cifertech/nRFBox/Schematic/nRFBOX-Schematic.jpg

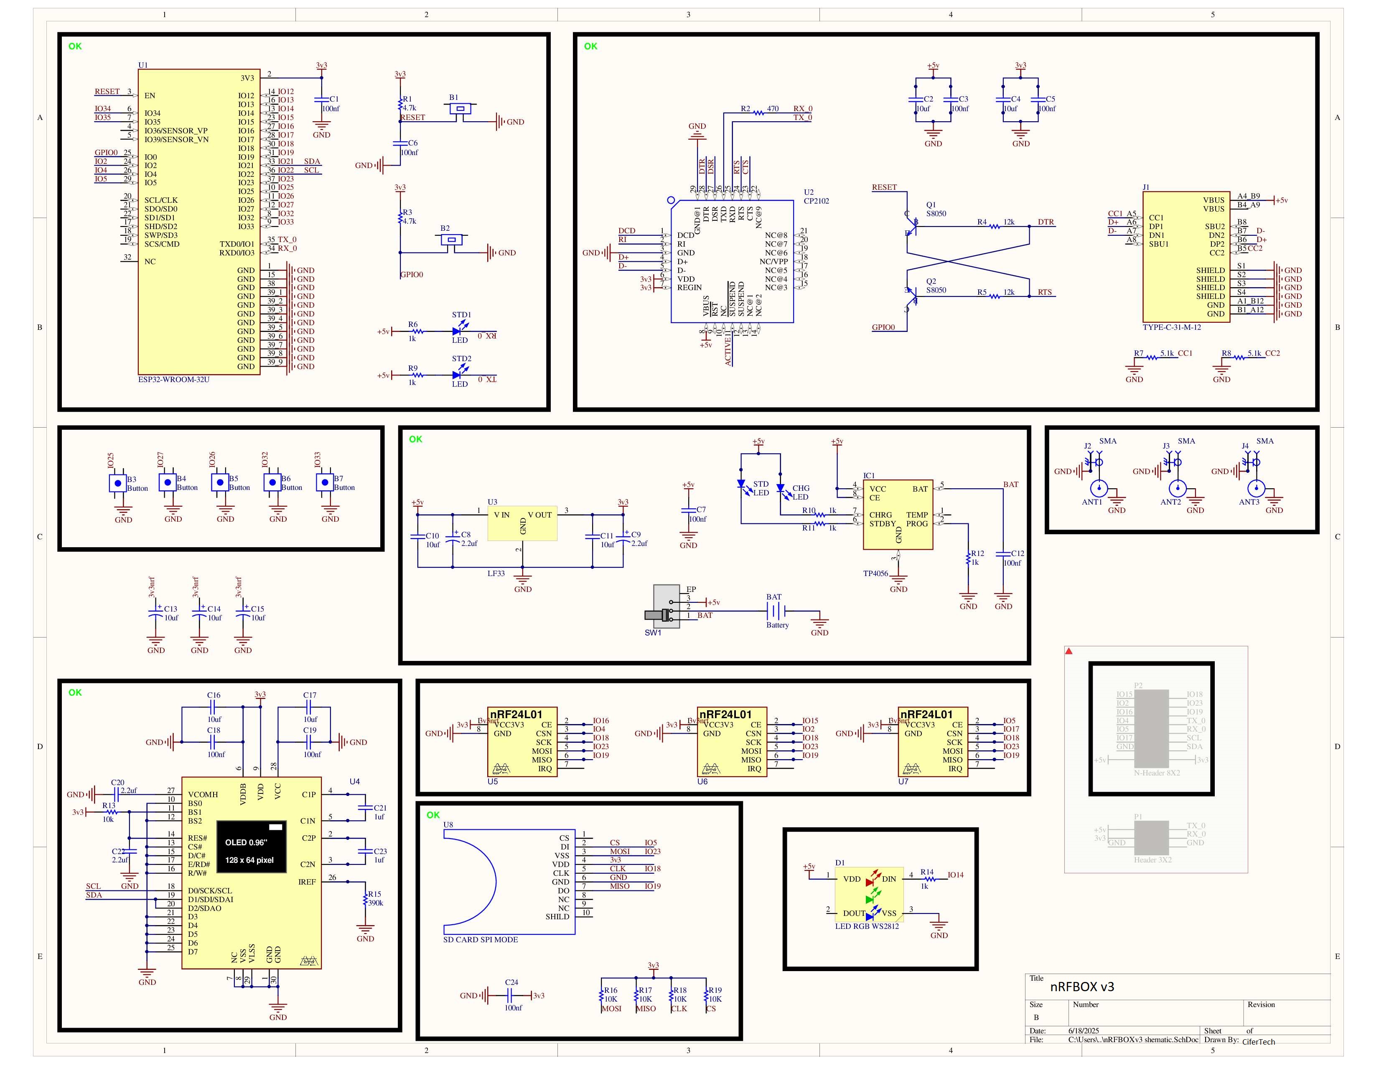
Schematic/nRFBOX-Schematic.jpg
