cifertech/nRFBox/PCB/PCB Print.jpg

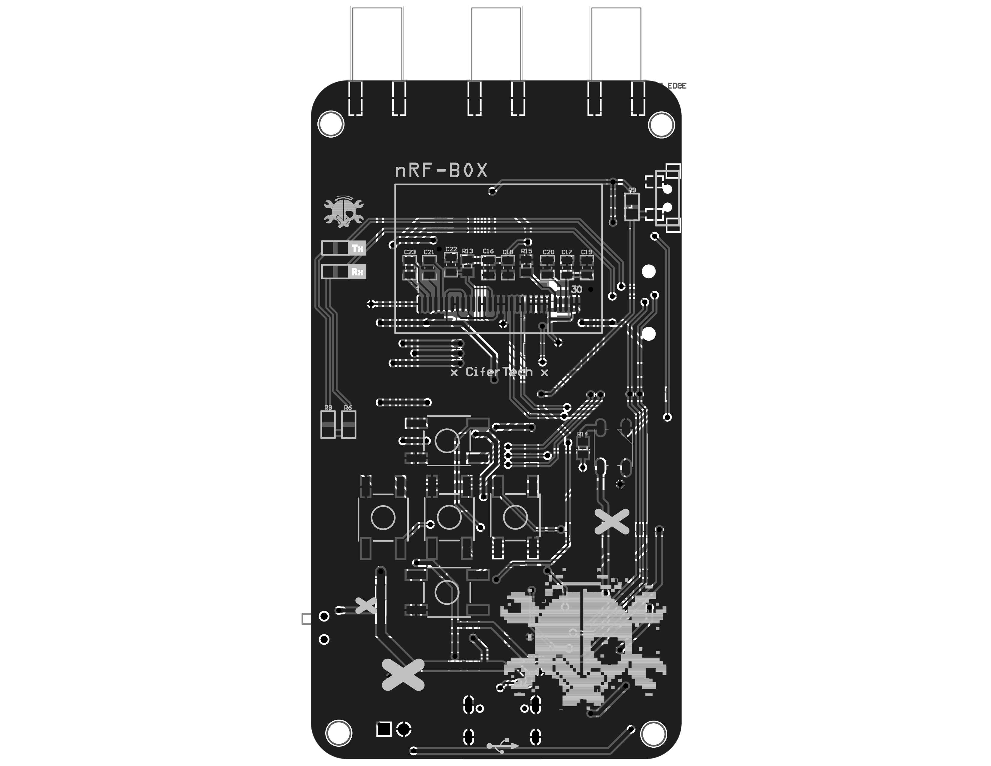
PCB/PCB Print.jpg
