cifertech/nRFBox/(threads)

Thread 5 (2023-02-10):

Rotary Encoder vs Buttons

AnonymeusOfficial, 2023-02-10:
Is there a way I can make this possible to use with a single rotary encoder, one direction is up and another is down the button would be to click enter and I'd use just one button for the back action.

jfjyfdyj6, 2025-07-19:
I used this one,its fit perfectly !

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

Thread 6 (2023-02-27):

pcb

Clayrecovery20, 2023-02-27:
can i get pcb design?

jlescalonap, 2024-08-23:
@cifertech could you sell the PCB design?

cifertech, 2024-09-04:
I have uploaded the PCB files for nRF-BOX V2.

https://github.com/cifertech/nRFBox/tree/main/PCB

zRCrackiiN, 2024-09-20:
I've assembled 2 now, both seem to have power issues, LF33 gets hot real fast I'm not even sure where to start diagnosing it haha

cifertech, 2024-09-20:
Hi @zRCrackiiN
Please provide photos of your assembled PCB and test your nRF-BOX without the C8 and C9 capacitors.

jlescalonap, 2024-09-20:
Sorry if this is not the right place to answer but, where did you order the PCBs? @zRCrackiiN

zRCrackiiN, 2024-09-20:
> Sorry if this is not the right place to answer but, where did you order the PCBs? @zRCrackiiN

pcbway

cifertech, 2024-09-20:
> im not sure i understand the power switch, when switched down (linking bat to BT1) it links the battery to the 4056, but when its up it links BT1 to +5v?

It's a clumsy logic design for controlling battery charging and powering on/off when the battery is connected, but it works.

If you are still experiencing issues with LF33, try to locate a short circuit. It's better to do the first tests with just one nRF24.

By the way, it's nice to see the nRF-BOX in purple!

zRCrackiiN, 2024-09-20:
I have a second board without the esp and the nrf modules, it's doing the same thing, definitely down the bottom of the board somewhere

cifertech, 2024-09-20:
> I have a second board without the esp and the nrf modules, it's doing the same thing, definitely down the bottom of the board somewhere

**Just following up on the LF33.**

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

zRCrackiiN, 2024-09-21:
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

im currently looking at this, i found that it was going to ground when not powered on the 5v side, when powered it stops going to ground, and powers up, but there is no output.

im also noticing that mine say ST GN LF33, not like yours, i cant find a spec sheet for the GN variant so i might need to try source other LF33 chips

zRCrackiiN, 2024-09-21:
basically, ive removed the GN LF33, added bench power to the 3v3 circuit and plugged in the usb, i was able to program and test, working well! i wonder if it really is just that reg!

jlescalonap, 2024-09-24:
> basically, ive removed the GN LF33, added bench power to the 3v3 circuit and plugged in the usb, i was able to program and test, working well! i wonder if it really is just that reg!

Could you please share how it enden up? @zRCrackiiN

zRCrackiiN, 2024-09-24:
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

I'll share after I've got the new lf33 added to the board, hopefully that fixes my issues

zRCrackiiN, 2024-11-20:
> Hey there @zRCrackiiN did you manage to solve the problem?

Yes, it appears to be bad LF33 components, my first order was from aliexpress, none of them worked.

Second order was from digikey and they work great

illlumin, 2024-12-06:
@zRCrackiiN,  could you share the 3D printing file? I’ve already ordered the circuit board and am currently looking for an enclosure for it. thank you

zRCrackiiN, 2024-12-30:
> @zRCrackiiN, could you share the 3D printing file? I’ve already ordered the circuit board and am currently looking for an enclosure for it. thank you

hey mate,
currently still in development but getting closer
![Uploading rn_image_picker_lib_temp_ab61d803-11be-495c-a5f5-df8ef0b73bba.jpg…]()

zRCrackiiN, 2024-12-30:
> @zRCrackiiN, could you share the 3D printing file? I’ve already ordered the circuit board and am currently looking for an enclosure for it. thank you

hey mate,
currently still in development but getting closer
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

Jeremiah-oAT, 2025-01-18:
I'm looking to have PCBWay completely assemble a few of these units. Does anyone have the pick and place files?

Thread 8 (2023-08-02):

Adafruit_SSD1306.h

MassFrequencies, 2023-08-02:
Hi,

can you please help me with this issue.

\Documents\Arduino\libraries\Adafruit_SSD1306\Adafruit_SSD1306.cpp:42:10: fatal error: pgmspace.h: No such file or directory
 #include <pgmspace.h>
          ^~~~~~~~~~~~
compilation terminated.

Thread 9 (2024-04-19):

No jamming code freezes

Ct114, 2024-04-19:
Compiled and uploaded as specified when in the jamming menu shows disabled and pressing button 2 causes the code to freeze

Thread 11 (2024-09-02):

PCB Gerber File

jayrogogn, 2024-09-02:
Hi, I didn't find the Gerber file in the main menu.
It is not in the "PCB" folder.
Could you make it available?

cifertech, 2024-09-04:
Hi @jayrogogn
I added the Gerber file, but you can also use .pcbdoc to order the PCB. Please ensure there are no issues before placing the order.

https://github.com/cifertech/nRFBox/tree/main/PCB

knlklabacka, 2024-09-09:
Good morning!  I uploaded the PCB file to JLCPCB and there are issues with the PCB that I'm not sure how to address.  Can you help?  The messages are from JLCPCB.

First issue:
As shown for 2 layer board ,the minimum via size is 0.3mm and the minimum via diameter is 0.5mm, can we increase the hole size and diameter to meet our capabilities?

Second issue:
slots in outline layer will cut the traces, should we delete them to proceed?
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

atsigr, 2024-10-12:
@cifertech i guess the pcb is with altium? Just a question, can you share the altium project so maybe we can adjust the pcb maybe for some of the materials ?

Thread 13 (2024-09-14):

spi communication problem

CtlAltDel6, 2024-09-14:
Breadboard build only works with a single radio attatched to the spi channel. Built with nodemcu wroom32 and using nrf24l01 + modules and breakout boards. I have only a single channel scope so I am unable to watch both ce and csn lines to confirm signal timing and transmition from multiple radios concurrently. Have confirmed spi coms as the issue by running diodes to spi on second and third radios. With that setup I get three radios active in multi jaming and a reliable signal in scanner and analyzer from radio 1, but of course no mesurable signal from radio 2 or 3.
I have tried 2 different proto board variations hoping that my jumper wires were at fault but both have failed.

opskrip, 2024-09-16:
Hello. I have the same story, but I don't understand it. Can you post a photo of how you did it?

CtlAltDel6, 2024-09-16:
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
I connected radio 1 straight to the spi bus pins and used three high speed switching diodes to connect both radio 2 and 3 together to the spi pins. This allows for the prepare radio logic to run and returns active on multi ble jammer.
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

CtlAltDel6, 2024-09-16:
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
Both prototype builds have the same issue

CtlAltDel6, 2024-09-16:
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
Both prototype builds fail in the same way

opskrip, 2024-09-17:
Thank you very much. I'm new to arduino, so I'm learning how to code through third-party projects. Have a nice day

cifertech, 2024-09-20:
Hi @CtlAltDel6
as I tested the project with 3 nRF24, your problem might be a power issue, but the SPI communication is always on the table, I will try to test to see if I can find the problem. If both prototypes fail in the same way, there might be something wrong with my code, but I will try to test it again.

By the way, that's a really impressive prototype.

CtlAltDel6, 2024-12-29:
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
Fixed in last update, rushed a messy case. 8.2" long, 3.6" wide, 1.2" depth including antenna. Thank you for all your hard work Cifertech

CtlAltDel6, 2024-12-29:
Closed, fully functional coms after update

Closed 2024-12-29.

Thread 15 (2024-09-17):

jammer transmission failed

marriusco, 2024-09-17:
Hi,
On Jamer. I get
Transmission failed, though scanning and analyzing works,

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

 so the NRF seems alive.

I double-checked the MISO MOSI SCK IRQ CS, I even changed the NRF.

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

Any idea ?

cifertech, 2024-09-20:
Hi @marriusco
The "Transmission failed" message is a bug that I will fix in the release. It's best to test the jammer with your IoT devices. Keep in mind that the jammer in nRF-BOX is not extremely powerful, but with the suitable options chosen in the jammer menu, it will work.

Thread 16 (2024-09-28):

OLED screen not working

logm1lo, 2024-09-28:
When I complied and flashed the code to esp32 WROOM U and connected the OLED screen to the esp32. The screen won't boot

logm1lo, 2024-09-28:
this is the output of the serial monitor

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

logm1lo, 2024-09-28:
the fix here is to wait for a couple of hours and turn it back again. Works like a charm

Dev-Khrish, 2024-12-18:
how did you get it to work ?

logm1lo, 2024-12-20:
> how did you get it to work ?

I still doesn't understand why I got it to work

Dev-Khrish, 2024-12-20:
Can you share a bit of schematics/screenshots of wiring or the code you used please

logm1lo, 2024-12-23:
> Can you share a bit of schematics/screenshots of wiring or the code you used please

Here it is, it's a bit messy tho:
https://github.com/cifertech/nRFBox/issues/17

Closed 2024-09-28.

Thread 17 (2024-09-28):

Button wiring doesn't work

logm1lo, 2024-09-28:
I've tried to wire the buttons to the breadboard and ESP32 as guided, but the buttons seems like it doesn't respond or received my inputs

Here are a couple of photos of the wiring:

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

logm1lo, 2024-09-28:
Also, love the project that you're building. It's fantastic!

Thread 18 (2024-09-29):

USB connector

marriusco, 2024-09-29:
The PCB for the usb female, what is the USB type.

atsigr, 2024-10-12:
@marriusco  Yes it is 3.1 and i believe this mach the footprint.
https://www.snapeda.com/parts/TYPE-C-31-M-12/HRO%20Electronics%20Co.,%20Ltd./view-part/

Thread 19 (2024-09-29):

Missing info on BOM

SoLongSidekick, 2024-09-29:
The tantalum cap at C8/C9 doesn't have a value listed in the BOM, anyone figure it out? Also is it safe to assume the rest of the caps are standard ceramic caps?

atsigr, 2024-10-12:
@SoLongSidekick If you see schematic C8/C9 is 2.2 uf (1206 footprint) . As for the other capacitors are 805 and some are 1206 (C10,C11) footprint (yes ceramic).

Thread 20 (2024-10-12):

Difference between 1KOhm 0805 resistor and 1KOhm 0805 (2012X06L) resistor?

VNEvil, 2024-10-12:
Hello @cifertech  and everyone!

In the 'nRFBOXv2 BOM.pdf' list, there are two types of resistors: 1KOhm 0805 and 1KOhm 0805 (2012X06L). Is there any difference between them? Can I use the 1KOhm 0805 (2012M) resistor to replace the 1KOhm 0805 (2012X06L) resistor?
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

I am looking forward to receiving a response
Thank you very much!

atsigr, 2024-10-13:
@VNEvil i think the 2012X06L. is on the metric System were is corect 2012M and 06 is the pad size as standrad all the 0805 RES are. Pretty sure you can use 1KOhm 0805 (2012M)

VNEvil, 2024-10-13:
Thank you!

UrbanTrip96, 2025-02-13:
> @VNEvil i think the 2012X06L. is on the metric System were is corect 2012M and 06 is the pad size as standrad all the 0805 RES are. Pretty sure you can use 1KOhm 0805 (2012M)

Are they interchangeable?

Thread 21 (2024-10-14):

.bin not working

sameepgod, 2024-10-14:
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

i have been trying to make this project decided to test it out on breadboard  but im not the output

mahmoudgamalmmg8, 2024-10-19:
i have same problem did u find a solution?

abasith-ak, 2024-11-04:
same bro

amir8el2, 2024-11-27:
I have this problem too. Has anyone been able to fix this problem?

ahmadjutt611, 2024-12-13:
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
 I have also same issue the bin is not showing any display but if upload code with ARDUINO IDE then there are many errors in code and after error resolve the display is working also analyzer working but jammer not working

Thread 23 (2024-10-25):

it's not working at all

abasith-ak, 2024-10-25:
I uploaded the bin to esp32, but it's not working at all. The screen doesn't turn on.

abasith-ak, 2024-10-25:
@cifertech  pls help

Thread 24 (2024-10-27):

The radio.write() always returns 0.

gugo2808, 2024-10-27:
Hello, today built the 3 nrf Version in breadboard with esp32s3.

All seems to be fine, but, radio.write() returns always 0, so I don't understand whether it working, or just auto-ack doesn't work.

I don't understand how to jam something actually, all my devices, like my watch or headphones remained connected.

I'm using nrf24l01+

Thank you! And good luck with development!😃

Thread 25 (2024-11-07):

nrf-box v1

ElamrawyTamer, 2024-11-07:
Hi, can you please send the schematics of the firse nrf-box? I just don't know how to connect buttons, charging controller and, etc? It's just I already built the second version and want to test the first one. Thank you

knlklabacka, 2024-11-08:
@ElamrawyTamer can you help me with version 2?  Can you share how you got it working?  Did you order a PCB?  I tried uploading the file to JLCPCB and they came back with the board had errors.

ElamrawyTamer, 2024-11-08:
@knlklabacka i used breadboard and i did soldering with the jumper wires, because I didn't want to risk buying wrong PCBs. I also found a video on tiktok, that helped me a lot: https://www.tiktok.com/@testando_tecnologias/video/7425052647775849734

knlklabacka, 2024-11-08:
Thank you @ElamrawyTamer I will take a look.

ElamrawyTamer, 2024-11-09:
@cifertech ?

SoLongSidekick, 2024-11-30:
> @knlklabacka i used breadboard and i did soldering with the jumper wires, because I didn't want to risk buying wrong PCBs. I also found a video on tiktok, that helped me a lot: https://www.tiktok.com/@testando_tecnologias/video/7425052647775849734

No way, no freaking way. Get the fuck out of here, nice find my dude. Crap, this means I finally have to just sack up and add Tiktok to my media appetite. Seriously, thanks for posting.

I'm... ... eh... 60-80% positive I downloaded the PCB Gerbers before v2 ever came out. I bookmarked this page well before v2 so it's very plausible. I'll dig around a bit and see if that is indeed the case, and if so I'll report back here.

AntonioDVZ, 2025-04-27:
> Hi, can you please send the schematics of the firse nrf-box? I just don't know how to connect buttons, charging controller and, etc? It's just I already built the second version and want to test the first one. Thank you

Hi. If you received the schematic version 1, can you send it to me?

Thread 26 (2024-11-13):

missing cpl file?

Spacedreamer0, 2024-11-13:
hello i wanted to follow the project but i don't have the required experience or tools to assemble it and wanted to have it assembled on jlcpcb but it asks me for a cpl file which i cant find. Do i miss something?

zarni99, 2024-11-28:
I also looking for cpl file and does anyone has share it here, please

nechry, 2024-12-18:
I'm also looking for the BOM and CPL for jlcpcb format.

gel3k, 2024-12-27:
also interested

knlklabacka, 2024-12-27:
Also interested

nechry, 2025-01-02:
I tried to order only PCB via jlcpcb, but the provided Gerber didn't pass the audit. is the reason:
There are minimum hole size of 0.25 mm, with a diameter of 0.35mm in your file, to ensure the quality for your order, the 4-Wire Kelvin Test and via filling are necessary, so you may need to pay for an extra cost for it.

Thread 28 (2024-12-06):

Graber file error: via hole issue

illlumin, 2024-12-06:
Thank you for this amazing project! I have downloaded the Gerber file for production, but the manufacturer informed me about an issue with the file. How can I fix this problem? I would greatly appreciate your support. Thank you!
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

"The file shows that the via hole has an inner diameter of 0.25mm and an outer diameter of 0.35mm, which exceeds our standard production process. (For single-sided and double-sided boards, the minimum hole diameter is typically 0.3mm, and the outer diameter is 0.4mm.)"

UrbanTrip96, 2025-02-17:
I have the same problem. What should I do?

Thread 32 (2024-12-24):

when a press enter in different options freezes and need to restart

SSnoody, 2024-12-24:
idk if is the new verision or my firmware is broke, i try with 2 diff esp32 and still the same thing, i actually flash both with arduino ide, the .bin way it doesnt flash the esp32

akftec, 2025-01-12:
i have same problem. did u found a solution?

akftec, 2025-01-12:
hi i found my problem. i think u have same problem
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

SSnoody, 2025-01-12:
> hi i found my problem. i think u have same problem just follow this ![image](https://private-user-images.githubusercontent.com/194712128/402380723-d080e17c-ad8f-41c1-ad5e-42cc400ca090.png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)

I have that config too, but still frozen, for example if i press the jammer it works, if i go back and press the jammer again it froze it, i cant press the same function again because it froze

akftec, 2025-01-13:
https://randomnerdtutorials.com/esp32-erase-flash-memory/ hi can u try this  if u cant acces python in terminal  try the install in microsoft store.  and i used the esp32 library version is 1.0.5 try this version after all this upload esp32  on arduino ide

Thread 34 (2024-12-29):

error: cannot convert 'std::string'

ahmadjutt611, 2024-12-29:
I have these error in spoofer.cpp in the switches

switch (deviceType) {
  case 1:
    oAdvertisementData.setManufacturerData(String((char *)dataAirpods).substring(0, 31));
    break;
  case 2:
    oAdvertisementData.setManufacturerData(String((char *)dataAirpodsPro).substring(0, 31));
    break;
  case 3:
    oAdvertisementData.setManufacturerData(String((char *)dataAirpodsMax).substring(0, 31));
    break;
  case 4:
    oAdvertisementData.setManufacturerData(String((char *)dataAirpodsGen2).substring(0, 31));
    break;

wajiho23, 2024-12-29:
I have the same error: `C:\Users\wajih\Downloads\nRFBox-2.2.1\nRFBox-2.2.1\nRFBox_V2\sourapple.cpp: In function 'BLEAdvertisementData getOAdvertisementData()':
C:\Users\wajih\Downloads\nRFBox-2.2.1\nRFBox-2.2.1\nRFBox_V2\sourapple.cpp:78:34: error: cannot convert 'std::string' {aka 'std::__cxx11::basic_string<char>'} to 'String'
   78 |   advertisementData.addData(std::string((char *)packet, 17));
      |                                  ^~~~~~~~~~~~~~~~~~~~~~~~~~
      |                                  |
      |                                  std::string {aka std::__cxx11::basic_string<char>}
In file included from C:\Users\wajih\AppData\Local\Arduino15\packages\esp32\hardware\esp32\3.0.7\libraries\BLE\src/BLEServer.h:22,
                 from C:\Users\wajih\AppData\Local\Arduino15\packages\esp32\hardware\esp32\3.0.7\libraries\BLE\src/BLEDevice.h:21,
                 from C:\Users\wajih\Downloads\nRFBox-2.2.1\nRFBox-2.2.1\nRFBox_V2\sourapple.h:9,
                 from C:\Users\wajih\Downloads\nRFBox-2.2.1\nRFBox-2.2.1\nRFBox_V2\sourapple.cpp:7:
C:\Users\wajih\AppData\Local\Arduino15\packages\esp32\hardware\esp32\3.0.7\libraries\BLE\src/BLEAdvertising.h:36:23: note:   initializing argument 1 of 'void BLEAdvertisementData::addData(String)'
   36 |   void addData(String data);  // Add data to the payload.
      |                ~~~~~~~^~~~
C:\Users\wajih\Downloads\nRFBox-2.2.1\nRFBox-2.2.1\nRFBox_V2\spoofer.cpp: In function 'void setAdvertisingData()':
C:\Users\wajih\Downloads\nRFBox-2.2.1\nRFBox-2.2.1\nRFBox_V2\spoofer.cpp:197:49: error: cannot convert 'std::string' {aka 'std::__cxx11::basic_string<char>'} to 'String'
  197 |     oAdvertisementData.setManufacturerData(std::string((char *)dataAirpods, 31));
      |                                                 ^~~~~~~~~~~~~~~~~~~~~~~~~~~~~~~
      |                                                 |
      |                                                 std::string {aka std::__cxx11::basic_string<char>}
In file included from C:\Users\wajih\AppData\Local\Arduino15\packages\esp32\hardware\esp32\3.0.7\libraries\BLE\src/BLEServer.h:22,
                 from C:\Users\wajih\AppData\Local\Arduino15\packages\esp32\hardware\esp32\3.0.7\libraries\BLE\src/BLEDevice.h:21,
                 from C:\Users\wajih\Downloads\nRFBox-2.2.1\nRFBox-2.2.1\nRFBox_V2\spoofer.h:9,
                 from C:\Users\wajih\Downloads\nRFBox-2.2.1\nRFBox-2.2.1\nRFBox_V2\spoofer.cpp:7:
C:\Users\wajih\AppData\Local\Arduino15\packages\esp32\hardware\esp32\3.0.7\libraries\BLE\src/BLEAdvertising.h:31:35: note:   initializing argument 1 of 'void BLEAdvertisementData::setManufacturerData(String)'
   31 |   void setManufacturerData(String data);
      |                            ~~~~~~~^~~~
C:\Users\wajih\Downloads\nRFBox-2.2.1\nRFBox-2.2.1\nRFBox_V2\spoofer.cpp:200:49: error: cannot convert 'std::string' {aka 'std::__cxx11::basic_string<char>'} to 'String'
  200 |     oAdvertisementData.setManufacturerData(std::string((char *)dataAirpodsPro, 31));
      |                                                 ^~~~~~~~~~~~~~~~~~~~~~~~~~~~~~~~~~
      |                                                 |
      |                                                 std::string {aka std::__cxx11::basic_string<char>}
C:\Users\wajih\AppData\Local\Arduino15\packages\esp32\hardware\esp32\3.0.7\libraries\BLE\src/BLEAdvertising.h:31:35: note:   initializing argument 1 of 'void BLEAdvertisementData::setManufacturerData(String)'
   31 |   void setManufacturerData(String data);
      |                            ~~~~~~~^~~~
C:\Users\wajih\Downloads\nRFBox-2.2.1\nRFBox-2.2.1\nRFBox_V2\spoofer.cpp:203:49: error: cannot convert 'std::string' {aka 'std::__cxx11::basic_string<char>'} to 'String'
  203 |     oAdvertisementData.setManufacturerData(std::string((char *)dataAirpodsMax, 31));
      |                                                 ^~~~~~~~~~~~~~~~~~~~~~~~~~~~~~~~~~
      |                                                 |
      |                                                 std::string {aka std::__cxx11::basic_string<char>}
C:\Users\wajih\AppData\Local\Arduino15\packages\esp32\hardware\esp32\3.0.7\libraries\BLE\src/BLEAdvertising.h:31:35: note:   initializing argument 1 of 'void BLEAdvertisementData::setManufacturerData(String)'
   31 |   void setManufacturerData(String data);
      |                            ~~~~~~~^~~~
C:\Users\wajih\Downloads\nRFBox-2.2.1\nRFBox-2.2.1\nRFBox_V2\spoofer.cpp:206:49: error: cannot convert 'std::string' {aka 'std::__cxx11::basic_string<char>'} to 'String'
  206 |     oAdvertisementData.setManufacturerData(std::string((char *)dataAirpodsGen2, 31));
      |                                                 ^~~~~~~~~~~~~~~~~~~~~~~~~~~~~~~~~~~
      |                                                 |
      |                                                 std::string {aka std::__cxx11::basic_string<char>}
C:\Users\wajih\AppData\Local\Arduino15\packages\esp32\hardware\esp32\3.0.7\libraries\BLE\src/BLEAdvertising.h:31:35: note:   initializing argument 1 of 'void BLEAdvertisementData::setManufacturerData(String)'
   31 |   void setManufacturerData(String data);
      |                            ~~~~~~~^~~~
C:\Users\wajih\Downloads\nRFBox-2.2.1\nRFBox-2.2.1\nRFBox_V2\spoofer.cpp:209:49: error: cannot convert 'std::string' {aka 'std::__cxx11::basic_string<char>'} to 'String'
  209 |     oAdvertisementData.setManufacturerData(std::string((char *)dataAirpodsGen3, 31));
      |                                                 ^~~~~~~~~~~~~~~~~~~~~~~~~~~~~~~~~~~
      |                                                 |
      |                                                 std::string {aka std::__cxx11::basic_string<char>}
C:\Users\wajih\AppData\Local\Arduino15\packages\esp32\hardware\esp32\3.0.7\libraries\BLE\src/BLEAdvertising.h:31:35: note:   initializing argument 1 of 'void BLEAdvertisementData::setManufacturerData(String)'
   31 |   void setManufacturerData(String data);
      |                            ~~~~~~~^~~~
C:\Users\wajih\Downloads\nRFBox-2.2.1\nRFBox-2.2.1\nRFBox_V2\spoofer.cpp:212:49: error: cannot convert 'std::string' {aka 'std::__cxx11::basic_string<char>'} to 'String'
  212 |     oAdvertisementData.setManufacturerData(std::string((char *)dataAirpodsProGen2, 31));
      |                                                 ^~~~~~~~~~~~~~~~~~~~~~~~~~~~~~~~~~~~~~
      |                                                 |
      |                                                 std::string {aka std::__cxx11::basic_string<char>}
C:\Users\wajih\AppData\Local\Arduino15\packages\esp32\hardware\esp32\3.0.7\libraries\BLE\src/BLEAdvertising.h:31:35: note:   initializing argument 1 of 'void BLEAdvertisementData::setManufacturerData(String)'
   31 |   void setManufacturerData(String data);
      |                            ~~~~~~~^~~~
C:\Users\wajih\Downloads\nRFBox-2.2.1\nRFBox-2.2.1\nRFBox_V2\spoofer.cpp:215:49: error: cannot convert 'std::string' {aka 'std::__cxx11::basic_string<char>'} to 'String'
  215 |     oAdvertisementData.setManufacturerData(std::string((char *)dataPowerBeats, 31));
      |                                                 ^~~~~~~~~~~~~~~~~~~~~~~~~~~~~~~~~~
      |                                                 |
      |                                                 std::string {aka std::__cxx11::basic_string<char>}
C:\Users\wajih\AppData\Local\Arduino15\packages\esp32\hardware\esp32\3.0.7\libraries\BLE\src/BLEAdvertising.h:31:35: note:   initializing argument 1 of 'void BLEAdvertisementData::setManufacturerData(String)'
   31 |   void setManufacturerData(String data);
      |                            ~~~~~~~^~~~
C:\Users\wajih\Downloads\nRFBox-2.2.1\nRFBox-2.2.1\nRFBox_V2\spoofer.cpp:218:49: error: cannot convert 'std::string' {aka 'std::__cxx11::basic_string<char>'} to 'String'
  218 |     oAdvertisementData.setManufacturerData(std::string((char *)dataPowerBeatsPro, 31));
      |                                                 ^~~~~~~~~~~~~~~~~~~~~~~~~~~~~~~~~~~~~
      |                                                 |
      |                                                 std::string {aka std::__cxx11::basic_string<char>}
C:\Users\wajih\AppData\Local\Arduino15\packages\esp32\hardware\esp32\3.0.7\libraries\BLE\src/BLEAdvertising.h:31:35: note:   initializing argument 1 of 'void BLEAdvertisementData::setManufacturerData(String)'
   31 |   void setManufacturerData(String data);
      |                            ~~~~~~~^~~~
C:\Users\wajih\Downloads\nRFBox-2.2.1\nRFBox-2.2.1\nRFBox_V2\spoofer.cpp:221:49: error: cannot convert 'std::string' {aka 'std::__cxx11::basic_string<char>'} to 'String'
  221 |     oAdvertisementData.setManufacturerData(std::string((char *)dataBeatsSoloPro, 31));
      |                                                 ^~~~~~~~~~~~~~~~~~~~~~~~~~~~~~~~~~~~
      |                                                 |
      |                                                 std::string {aka std::__cxx11::basic_string<char>}
C:\Users\wajih\AppData\Local\Arduino15\packages\esp32\hardware\esp32\3.0.7\libraries\BLE\src/BLEAdvertising.h:31:35: note:   initializing argument 1 of 'void BLEAdvertisementData::setManufacturerData(String)'
   31 |   void setManufacturerData(String data);
      |                            ~~~~~~~^~~~
C:\Users\wajih\Downloads\nRFBox-2.2.1\nRFBox-2.2.1\nRFBox_V2\spoofer.cpp:224:49: error: cannot convert 'std::string' {aka 'std::__cxx11::basic_string<char>'} to 'String'
  224 |     oAdvertisementData.setManufacturerData(std::string((char *)dataBeatsStudioBuds, 31));
      |                                                 ^~~~~~~~~~~~~~~~~~~~~~~~~~~~~~~~~~~~~~~
      |                                                 |
      |                                                 std::string {aka std::__cxx11::basic_string<char>}
C:\Users\wajih\AppData\Local\Arduino15\packages\esp32\hardware\esp32\3.0.7\libraries\BLE\src/BLEAdvertising.h:31:35: note:   initializing argument 1 of 'void BLEAdvertisementData::setManufacturerData(String)'
   31 |   void setManufacturerData(String data);
      |                            ~~~~~~~^~~~
C:\Users\wajih\Downloads\nRFBox-2.2.1\nRFBox-2.2.1\nRFBox_V2\spoofer.cpp:227:49: error: cannot convert 'std::string' {aka 'std::__cxx11::basic_string<char>'} to 'String'
  227 |     oAdvertisementData.setManufacturerData(std::string((char *)dataBeatsFlex, 31));
      |                                                 ^~~~~~~~~~~~~~~~~~~~~~~~~~~~~~~~~
      |                                                 |
      |                                                 std::string {aka std::__cxx11::basic_string<char>}
C:\Users\wajih\AppData\Local\Arduino15\packages\esp32\hardware\esp32\3.0.7\libraries\BLE\src/BLEAdvertising.h:31:35: note:   initializing argument 1 of 'void BLEAdvertisementData::setManufacturerData(String)'
   31 |   void setManufacturerData(String data);
      |                            ~~~~~~~^~~~
C:\Users\wajih\Downloads\nRFBox-2.2.1\nRFBox-2.2.1\nRFBox_V2\spoofer.cpp:230:49: error: cannot convert 'std::string' {aka 'std::__cxx11::basic_string<char>'} to 'String'
  230 |     oAdvertisementData.setManufacturerData(std::string((char *)dataBeatsX, 31));
      |                                                 ^~~~~~~~~~~~~~~~~~~~~~~~~~~~~~
      |                                                 |
      |                                                 std::string {aka std::__cxx11::basic_string<char>}
C:\Users\wajih\AppData\Local\Arduino15\packages\esp32\hardware\esp32\3.0.7\libraries\BLE\src/BLEAdvertising.h:31:35: note:   initializing argument 1 of 'void BLEAdvertisementData::setManufacturerData(String)'
   31 |   void setManufacturerData(String data);
      |                            ~~~~~~~^~~~
C:\Users\wajih\Downloads\nRFBox-2.2.1\nRFBox-2.2.1\nRFBox_V2\spoofer.cpp:233:49: error: cannot convert 'std::string' {aka 'std::__cxx11::basic_string<char>'} to 'String'
  233 |     oAdvertisementData.setManufacturerData(std::string((char *)dataBeatsSolo3, 31));
      |                                                 ^~~~~~~~~~~~~~~~~~~~~~~~~~~~~~~~~~
      |                                                 |
      |                                                 std::string {aka std::__cxx11::basic_string<char>}
C:\Users\wajih\AppData\Local\Arduino15\packages\esp32\hardware\esp32\3.0.7\libraries\BLE\src/BLEAdvertising.h:31:35: note:   initializing argument 1 of 'void BLEAdvertisementData::setManufacturerData(String)'
   31 |   void setManufacturerData(String data);
      |                            ~~~~~~~^~~~
C:\Users\wajih\Downloads\nRFBox-2.2.1\nRFBox-2.2.1\nRFBox_V2\spoofer.cpp:236:49: error: cannot convert 'std::string' {aka 'std::__cxx11::basic_string<char>'} to 'String'
  236 |     oAdvertisementData.setManufacturerData(std::string((char *)dataBeatsStudio3, 31));
      |                                                 ^~~~~~~~~~~~~~~~~~~~~~~~~~~~~~~~~~~~
      |                                                 |
      |                                                 std::string {aka std::__cxx11::basic_string<char>}
C:\Users\wajih\AppData\Local\Arduino15\packages\esp32\hardware\esp32\3.0.7\libraries\BLE\src/BLEAdvertising.h:31:35: note:   initializing argument 1 of 'void BLEAdvertisementData::setManufacturerData(String)'
   31 |   void setManufacturerData(String data);
      |                            ~~~~~~~^~~~
C:\Users\wajih\Downloads\nRFBox-2.2.1\nRFBox-2.2.1\nRFBox_V2\spoofer.cpp:239:49: error: cannot convert 'std::string' {aka 'std::__cxx11::basic_string<char>'} to 'String'
  239 |     oAdvertisementData.setManufacturerData(std::string((char *)dataBeatsStudioPro, 31));
      |                                                 ^~~~~~~~~~~~~~~~~~~~~~~~~~~~~~~~~~~~~~
      |                                                 |
      |                                                 std::string {aka std::__cxx11::basic_string<char>}
C:\Users\wajih\AppData\Local\Arduino15\packages\esp32\hardware\esp32\3.0.7\libraries\BLE\src/BLEAdvertising.h:31:35: note:   initializing argument 1 of 'void BLEAdvertisementData::setManufacturerData(String)'
   31 |   void setManufacturerData(String data);
      |                            ~~~~~~~^~~~
C:\Users\wajih\Downloads\nRFBox-2.2.1\nRFBox-2.2.1\nRFBox_V2\spoofer.cpp:242:49: error: cannot convert 'std::string' {aka 'std::__cxx11::basic_string<char>'} to 'String'
  242 |     oAdvertisementData.setManufacturerData(std::string((char *)dataBeatsFitPro, 31));
      |                                                 ^~~~~~~~~~~~~~~~~~~~~~~~~~~~~~~~~~~
      |                                                 |
      |                                                 std::string {aka std::__cxx11::basic_string<char>}
C:\Users\wajih\AppData\Local\Arduino15\packages\esp32\hardware\esp32\3.0.7\libraries\BLE\src/BLEAdvertising.h:31:35: note:   initializing argument 1 of 'void BLEAdvertisementData::setManufacturerData(String)'
   31 |   void setManufacturerData(String data);
      |                            ~~~~~~~^~~~
C:\Users\wajih\Downloads\nRFBox-2.2.1\nRFBox-2.2.1\nRFBox_V2\spoofer.cpp:245:49: error: cannot convert 'std::string' {aka 'std::__cxx11::basic_string<char>'} to 'String'
  245 |     oAdvertisementData.setManufacturerData(std::string((char *)dataBeatsStudioBudsPlus, 31));
      |                                                 ^~~~~~~~~~~~~~~~~~~~~~~~~~~~~~~~~~~~~~~~~~~
      |                                                 |
      |                                                 std::string {aka std::__cxx11::basic_string<char>}
C:\Users\wajih\AppData\Local\Arduino15\packages\esp32\hardware\esp32\3.0.7\libraries\BLE\src/BLEAdvertising.h:31:35: note:   initializing argument 1 of 'void BLEAdvertisementData::setManufacturerData(String)'
   31 |   void setManufacturerData(String data);
      |                            ~~~~~~~^~~~
C:\Users\wajih\Downloads\nRFBox-2.2.1\nRFBox-2.2.1\nRFBox_V2\spoofer.cpp:248:49: error: cannot convert 'std::string' {aka 'std::__cxx11::basic_string<char>'} to 'String'
  248 |     oAdvertisementData.setManufacturerData(std::string((char *)dataAppleTVSetup, 31));
      |                                                 ^~~~~~~~~~~~~~~~~~~~~~~~~~~~~~~~~~~~
      |                                                 |
      |                                                 std::string {aka std::__cxx11::basic_string<char>}
C:\Users\wajih\AppData\Local\Arduino15\packages\esp32\hardware\esp32\3.0.7\libraries\BLE\src/BLEAdvertising.h:31:35: note:   initializing argument 1 of 'void BLEAdvertisementData::setManufacturerData(String)'
   31 |   void setManufacturerData(String data);
      |                            ~~~~~~~^~~~
C:\Users\wajih\Downloads\nRFBox-2.2.1\nRFBox-2.2.1\nRFBox_V2\spoofer.cpp:251:49: error: cannot convert 'std::string' {aka 'std::__cxx11::basic_string<char>'} to 'String'
  251 |     oAdvertisementData.setManufacturerData(std::string((char *)dataAppleTVPair, 31));
      |                                                 ^~~~~~~~~~~~~~~~~~~~~~~~~~~~~~~~~~~
      |                                                 |
      |                                                 std::string {aka std::__cxx11::basic_string<char>}
C:\Users\wajih\AppData\Local\Arduino15\packages\esp32\hardware\esp32\3.0.7\libraries\BLE\src/BLEAdvertising.h:31:35: note:   initializing argument 1 of 'void BLEAdvertisementData::setManufacturerData(String)'
   31 |   void setManufacturerData(String data);
      |                            ~~~~~~~^~~~
C:\Users\wajih\Downloads\nRFBox-2.2.1\nRFBox-2.2.1\nRFBox_V2\spoofer.cpp:254:49: error: cannot convert 'std::string' {aka 'std::__cxx11::basic_string<char>'} to 'String'
  254 |     oAdvertisementData.setManufacturerData(std::string((char *)dataAppleTVNewUser, 31));
      |                                                 ^~~~~~~~~~~~~~~~~~~~~~~~~~~~~~~~~~~~~~
      |                                                 |
      |                                                 std::string {aka std::__cxx11::basic_string<char>}
C:\Users\wajih\AppData\Local\Arduino15\packages\esp32\hardware\esp32\3.0.7\libraries\BLE\src/BLEAdvertising.h:31:35: note:   initializing argument 1 of 'void BLEAdvertisementData::setManufacturerData(String)'
   31 |   void setManufacturerData(String data);
      |                            ~~~~~~~^~~~
C:\Users\wajih\Downloads\nRFBox-2.2.1\nRFBox-2.2.1\nRFBox_V2\spoofer.cpp:257:49: error: cannot convert 'std::string' {aka 'std::__cxx11::basic_string<char>'} to 'String'
  257 |     oAdvertisementData.setManufacturerData(std::string((char *)dataAppleTVAppleIDSetup, 31));
      |                                                 ^~~~~~~~~~~~~~~~~~~~~~~~~~~~~~~~~~~~~~~~~~~
      |                                                 |
      |                                                 std::string {aka std::__cxx11::basic_string<char>}
C:\Users\wajih\AppData\Local\Arduino15\packages\esp32\hardware\esp32\3.0.7\libraries\BLE\src/BLEAdvertising.h:31:35: note:   initializing argument 1 of 'void BLEAdvertisementData::setManufacturerData(String)'
   31 |   void setManufacturerData(String data);
      |                            ~~~~~~~^~~~
C:\Users\wajih\Downloads\nRFBox-2.2.1\nRFBox-2.2.1\nRFBox_V2\spoofer.cpp:260:49: error: cannot convert 'std::string' {aka 'std::__cxx11::basic_string<char>'} to 'String'
  260 |     oAdvertisementData.setManufacturerData(std::string((char *)dataAppleTVWirelessAudioSync, 31));
      |                                                 ^~~~~~~~~~~~~~~~~~~~~~~~~~~~~~~~~~~~~~~~~~~~~~~~
      |                                                 |
      |                                                 std::string {aka std::__cxx11::basic_string<char>}
C:\Users\wajih\AppData\Local\Arduino15\packages\esp32\hardware\esp32\3.0.7\libraries\BLE\src/BLEAdvertising.h:31:35: note:   initializing argument 1 of 'void BLEAdvertisementData::setManufacturerData(String)'
   31 |   void setManufacturerData(String data);
      |                            ~~~~~~~^~~~
C:\Users\wajih\Downloads\nRFBox-2.2.1\nRFBox-2.2.1\nRFBox_V2\spoofer.cpp:263:49: error: cannot convert 'std::string' {aka 'std::__cxx11::basic_string<char>'} to 'String'
  263 |     oAdvertisementData.setManufacturerData(std::string((char *)dataAppleTVHomekitSetup, 31));
      |                                                 ^~~~~~~~~~~~~~~~~~~~~~~~~~~~~~~~~~~~~~~~~~~
      |                                                 |
      |                                                 std::string {aka std::__cxx11::basic_string<char>}
C:\Users\wajih\AppData\Local\Arduino15\packages\esp32\hardware\esp32\3.0.7\libraries\BLE\src/BLEAdvertising.h:31:35: note:   initializing argument 1 of 'void BLEAdvertisementData::setManufacturerData(String)'
   31 |   void setManufacturerData(String data);
      |                            ~~~~~~~^~~~
C:\Users\wajih\Downloads\nRFBox-2.2.1\nRFBox-2.2.1\nRFBox_V2\spoofer.cpp:266:49: error: cannot convert 'std::string' {aka 'std::__cxx11::basic_string<char>'} to 'String'
  266 |     oAdvertisementData.setManufacturerData(std::string((char *)dataAppleTVKeyboard, 31));
      |                                                 ^~~~~~~~~~~~~~~~~~~~~~~~~~~~~~~~~~~~~~~
      |                                                 |
      |                                                 std::string {aka std::__cxx11::basic_string<char>}
C:\Users\wajih\AppData\Local\Arduino15\packages\esp32\hardware\esp32\3.0.7\libraries\BLE\src/BLEAdvertising.h:31:35: note:   initializing argument 1 of 'void BLEAdvertisementData::setManufacturerData(String)'
   31 |   void setManufacturerData(String data);
      |                            ~~~~~~~^~~~
C:\Users\wajih\Downloads\nRFBox-2.2.1\nRFBox-2.2.1\nRFBox_V2\spoofer.cpp:269:49: error: cannot convert 'std::string' {aka 'std::__cxx11::basic_string<char>'} to 'String'
  269 |     oAdvertisementData.setManufacturerData(std::string((char *)dataAppleTVConnectingToNetwork, 31));
      |                                                 ^~~~~~~~~~~~~~~~~~~~~~~~~~~~~~~~~~~~~~~~~~~~~~~~~~
      |                                                 |
      |                                                 std::string {aka std::__cxx11::basic_string<char>}
C:\Users\wajih\AppData\Local\Arduino15\packages\esp32\hardware\esp32\3.0.7\libraries\BLE\src/BLEAdvertising.h:31:35: note:   initializing argument 1 of 'void BLEAdvertisementData::setManufacturerData(String)'
   31 |   void setManufacturerData(String data);
      |                            ~~~~~~~^~~~
C:\Users\wajih\Downloads\nRFBox-2.2.1\nRFBox-2.2.1\nRFBox_V2\spoofer.cpp:272:49: error: cannot convert 'std::string' {aka 'std::__cxx11::basic_string<char>'} to 'String'
  272 |     oAdvertisementData.setManufacturerData(std::string((char *)dataTVColorBalance, 31));
      |                                                 ^~~~~~~~~~~~~~~~~~~~~~~~~~~~~~~~~~~~~~
      |                                                 |
      |                                                 std::string {aka std::__cxx11::basic_string<char>}
C:\Users\wajih\AppData\Local\Arduino15\packages\esp32\hardware\esp32\3.0.7\libraries\BLE\src/BLEAdvertising.h:31:35: note:   initializing argument 1 of 'void BLEAdvertisementData::setManufacturerData(String)'
   31 |   void setManufacturerData(String data);
      |                            ~~~~~~~^~~~
C:\Users\wajih\Downloads\nRFBox-2.2.1\nRFBox-2.2.1\nRFBox_V2\spoofer.cpp:275:49: error: cannot convert 'std::string' {aka 'std::__cxx11::basic_string<char>'} to 'String'
  275 |     oAdvertisementData.setManufacturerData(std::string((char *)dataAirpods, 31));
      |                                                 ^~~~~~~~~~~~~~~~~~~~~~~~~~~~~~~
      |                                                 |
      |                                                 std::string {aka std::__cxx11::basic_string<char>}
C:\Users\wajih\AppData\Local\Arduino15\packages\esp32\hardware\esp32\3.0.7\libraries\BLE\src/BLEAdvertising.h:31:35: note:   initializing argument 1 of 'void BLEAdvertisementData::setManufacturerData(String)'
   31 |   void setManufacturerData(String data);
      |                            ~~~~~~~^~~~

exit status 1

Compilation error: cannot convert 'std::string' {aka 'std::__cxx11::basic_string<char>'} to 'String'`

cifertech, 2024-12-29:
Hi, use version 1.0.5 of the ESP32 board and follow the instructions.

https://github.com/cifertech/nRFBox?tab=readme-ov-file#-uploading-the-firmware-bin-to-esp32

ahmadjutt611, 2024-12-30:
can you please give us the library's name and versions like BLE

ahmadjutt611, 2024-12-30:
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

after downgrading the esp version. Now shown this error.

ahmadjutt611, 2024-12-30:
If we install .bin then there is no display on the OLED

Closed 2024-12-30.

Thread 37 (2025-01-10):

bootloader and partition file missing

zhouyousong, 2025-01-10:
Hi ,when I flash the nRFBox_V2-1-1.ino.node32s.bin to 0x10000, the serial log as below

chat gpt told me I need download bootloader and partitions to
bootloader.bin → 0x1000
partitions.bin → 0x8000

is any one have these 2 files, thanks

configsip: 0, SPIWP:0xee
clk_drv:0x00,q_drv:0x00,d_drv:0x00,cs0_drv:0x00,hd_drv:0x00,wp_drv:0x00
mode:DIO, clock div:2
load:0x3fff0018,len:4
load:0x3fff001c,len:6932
load:0x40078000,len:13712
load:0x40080400,len:4260
entry 0x400806e4
 [0;32mI (107) boot: Chip Revision: 1 [0m
 [0;32mI (127) boot_comm: chip revision: 1, min. bootloader chip revision: 0 [0m
 [0;32mI (78) boot: ESP-IDF v4.0.1-193-ge7ac221 2nd stage bootloader [0m
 [0;32mI (78) boot: compile time 02:47:00 [0m
 [0;32mI (78) boot: Enabling RNG early entropy source... [0m
 [0;32mI (84) boot: SPI Speed      : 40MHz [0m
 [0;32mI (89) boot: SPI Mode       : DIO [0m
 [0;32mI (93) boot: SPI Flash Size : 4MB [0m
 [0;32mI (97) boot: Partition Table: [0m
 [0;32mI (100) boot: ## Label            Usage          Type ST Offset   Length [0m
 [0;32mI (108) boot:  0 phy_init         RF data          01 01 0000f000 00001000 [0m
 [0;32mI (115) boot:  1 otadata          OTA data         01 00 00010000 00002000 [0m
 [0;32mI (123) boot:  2 nvs              WiFi data        01 02 00012000 0000e000 [0m
 [0;32mI (130) boot:  3 at_customize     unknown          40 00 00020000 000e0000 [0m
 [0;32mI (138) boot:  4 ota_0            OTA app          00 10 00100000 00180000 [0m
 [0;32mI (145) boot:  5 ota_1            OTA app          00 11 00280000 00180000 [0m
 [0;32mI (153) boot: End of partition table [0m
 [0;31mE (157) boot: ota data partition invalid and no factory, will try all partitions [0m
 [0;31mE (165) esp_image: image at 0x100000 has invalid magic byte [0m
 [0;31mE (172) boot_comm: mismatch chip ID, expected 0, found 8 [0m
 [0;31mE (178) boot_comm: can't run on lower chip revision, expected 1, found 12 [0m
 [0;33mW (185) esp_image: image at 0x100000 has invalid SPI mode 22 [0m
 [0;33mW (191) esp_image: image at 0x100000 has invalid SPI size 14 [0m
 [0;31mE (198) boot: OTA app partition slot 0 is not bootable [0m
 [0;31mE (204) esp_image: image at 0x280000 has invalid magic byte [0m
 [0;31mE (210) boot_comm: mismatch chip ID, expected 0, found 65535 [0m
 [0;31mE (216) boot_comm: can't run on lower chip revision, expected 1, found 255 [0m
 [0;33mW (224) esp_image: image at 0x280000 has invalid SPI mode 255 [0m
 [0;33mW (230) esp_image: image at 0x280000 has invalid SPI size 15 [0m
 [0;31mE (236) boot: OTA app partition slot 1 is not bootable [0m
 [0;31mE (242) boot: No bootable app partitions in the partition table [0m
ets Jun  8 2016 00:22:57

rst:0x3 (SW_RESET),boot:0x13 (SPI_FAST_FLASH_BOOT)
configsip: 0, SPIWP:0xee
clk_drv:0x00,q_drv:0x00,d_drv:0x00,cs0_drv:0x00,hd_drv:0x00,wp_drv:0x00
mode:DIO, clock div:2
load:0x3fff0018,len:4
load:0x3fff001c,len:6932
load:0x40078000,len:13712
load:0x40080400,len:4260
entry 0x400806e4
 [0;32mI (107) boot: Chip Revision: 1 [0m
 [0;32mI (127) boot_comm: chip revision: 1, min. bootloader chip revision: 0 [0m
 [0;32mI (78) boot: ESP-IDF v4.0.1-193-ge7ac221 2nd stage bootloader [0m
 [0;32mI (78) boot: compile time 02:47:00 [0m
 [0;32mI (78) boot: Enabling RNG early entropy source... [0m
 [0;32mI (84) boot: SPI Speed      : 40MHz [0m
 [0;32mI (89) boot: SPI Mode       : DIO [0m
 [0;32mI (93) boot: SPI Flash Size : 4MB [0m
 [0;32mI (97) boot: Partition Table: [0m
 [0;32mI (100) boot: ## Label            Usage          Type ST Offset   Length [0m
 [0;32mI (108) boot:  0 phy_init         RF data          01 01 0000f000 00001000 [0m
 [0;32mI (115) boot:  1 otadata          OTA data         01 00 00010000 00002000 [0m
 [0;32mI (123) boot:  2 nvs              WiFi data        01 02 00012000 0000e000 [0m
 [0;32mI (130) boot:  3 at_customize     unknown          40 00 00020000 000e0000 [0m
 [0;32mI (138) boot:  4 ota_0            OTA app          00 10 00100000 00180000 [0m
 [0;32mI (145) boot:  5 ota_1            OTA app          00 11 00280000 00180000 [0m
 [0;32mI (153) boot: End of partition table [0m
 [0;31mE (157) boot: ota data partition invalid and no factory, will try all partitions [0m
 [0;31mE (165) esp_image: image at 0x100000 has invalid magic byte [0m
 [0;31mE (172) boot_comm: mismatch chip ID, expected 0, found 8 [0m
 [0;31mE (178) boot_comm: can't run on lower chip revision, expected 1, found 12 [0m
 [0;33mW (185) esp_image: image at 0x100000 has invalid SPI mode 22 [0m
 [0;33mW (191) esp_image: image at 0x100000 has invalid SPI size 14 [0m
 [0;31mE (198) boot: OTA app partition slot 0 is not bootable [0m
 [0;31mE (204) esp_image: image at 0x280000 has invalid magic byte [0m
 [0;31mE (210) boot_comm: mismatch chip ID, expected 0, found 65535 [0m
 [0;31mE (216) boot_comm: can't run on lower chip revision, expected 1, found 255 [0m
 [0;33mW (224) esp_image: image at 0x280000 has invalid SPI mode 255 [0m
 [0;33mW (230) esp_image: image at 0x280000 has invalid SPI size 15 [0m
 [0;31mE (236) boot: OTA app partition slot 1 is not bootable [0m
 [0;31mE (242) boot: No bootable app partitions in the partition table [0m
ets Jun  8 2016 00:22:57

cifertech, 2025-06-23:
Files are available here: https://github.com/cifertech/nRFBox/tree/main/Flash%20File

Also Read The Wiki!
https://github.com/cifertech/nRFBox/wiki

Thread 38 (2025-01-13):

Esp32 jammer

gduarteds, 2025-01-13:

Thread 40 (2025-01-20):

OLED Display Not Working After Program Upload

MohammadNabin, 2025-01-20:
After successfully compiling and uploading the nRFBox firmware to an ESP32 with an I2C-connected OLED display, the display remains black and does not show any output. The compilation errors related to exceeding program storage space were resolved by changing the partition scheme, but the OLED issue persists.

Steps to Reproduce:
Clone the latest nRFBox firmware repository.
Configure the project for an ESP32 board and ensure the correct wiring for an I2C OLED (e.g., SSD1306 128x64).
Adjust the partition scheme to "Minimal SPIFFS (1.9MB APP, 190KB SPIFFS)" in Arduino IDE.
Upload the program to the ESP32.
Observe that the OLED display remains black.

Environment Details
Board: ESP32 Dev Module
OLED Display: SSD1306 128x64 (I2C interface)
Arduino IDE Version: 2.3.4
Partition Scheme: Minimal SPIFFS (1.9MB APP, 190KB SPIFFS)
Firmware Version: v2.5.1
Libraries:
U8g2 for OLED display handling
Other dependencies from the repository
Troubleshooting Steps Taken
Verified wiring (VCC, GND, SCL, SDA) to ensure proper connections.
Checked the I2C address using an I2C scanner:
Result: The OLED was detected at 0x3C.
Tested the display with a minimal U8g2 example sketch:
Result: The display worked as expected with the example code.

DotNetInAction, 2025-01-26:
Same issue with ESP32 Wroom 32U. Code compiles and uploads but nothing on the screen. Tried taking things out line by line by removing neopixel, eeprom, radios but still nothing on the screen.

Flashing any previous version works straight away. Flashing latest bin getting same issue with blank screen.

RoToSpLaSh, 2025-01-29:
Make sure the SCL pin 22 and  SDA pin 21

dev-shrubb3ry, 2025-01-29:
Im pretty sure it is not a screen issue. I tried a minimal sketch with only usg8 library and screen does work. I have also tried another esp32 with the integrated screen and flashing previous image works straight away. Flashing newest nothing comes up. Sometimes I do observe what it seems a bootloop in a serial monitor tho.

It is a shame debugging is so hard on esp32 and arduino ide. I feel like it is most likely a dependency failure which would come up straight away. I been comparing previous tag code with newest and EEPROM looks like a good candidate as it gets initialized before anything comes up on screen and it was added in latest version.

dev-shrubb3ry, 2025-01-29:
Ok, I got that working.

It appeared to be esp32 issue. Switching to different board worked straight away. Flashing latest .bin still sends it into a bootloop, but compiling code and uploading directly works just fine.

marikuns, 2025-01-31:
Look spi address of your display and use `u8g2.setI2CAddress(0x78);` before begin. replace 0x78 with your value

Thread 47 (2025-03-02):

The problem is running nRFBox V2.5.0 on esp32 devkit v1 wroom32

Nicoldik, 2025-03-02:
Hello, trouble has happened, my esp32 devkit v1 wroom 32 does not work with the nRFBox V2.5.0 version, I flashed according to the instructions and rebooted, but it shows a black screen, that is, nothing help

Luigi-77, 2025-03-10:
Anche a me succede la stessa cosa con la versione 2.5.0

Thread 48 (2025-03-19):

Esp32 wroom 32u lcd not working

eoef, 2025-03-19:
I uploaded the bin file but the lcd is not working
Arduino has many errors when uploading
How do I solve this?

Closed 2025-03-20.

Thread 49 (2025-03-19):

Capacitors C8/C9 no voltage specified

GreyHatUser, 2025-03-19:
I built the entire thing, i noticed first time i ordered the capacitors wrong as i bought 10uf 10v capacitors, when in the schematic specifies 2.2uf, now, when i powered the device on both (of the wrong capacitors) got burnt, i wanted to make a **new order for the right capacitors for C8/C9**, but there is **no voltage specified**, **does anyone know what voltage should they be**?

Still, trying to connect the device with no C8/C9 capacitors wich should theoretically work, the tool doesnt get detected by the pc, i changed the USB  to UART chip in case it was broken but still nothing. Are the C8/C9 100% necessary?

UrbanTrip96, 2025-03-20:
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

В gerber файлах указано C8/C9 Tant 2.2uf

Я временно заменил на керамические конденсаторы 2.2uf и вроде всё работает. Компьютер видет esp32 и даже записывает прошивку, но не включается. Возможно дело в прошивке, пока не разобрался.

SunboX, 2025-04-22:
@UrbanTrip96 Do you have the complete Altium project? If so, could you send it to me please? I would like to do some changes.

Thread 52 (2025-03-24):

ESP32-WROOM-32 no flashing .bin nor Arduino IDE

St0rmy88, 2025-03-24:
this is the board:

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

I tried to flash the precompiled .bin file with ESP Tool, but without success.
Then, I attempted to upload the sketch using Arduino IDE, but I also encountered numerous errors.
Below are the Arduino IDE log and the screenshot from ESP Tool.

from arduino IDE:
C:\Users\...\nRFBox_V2\sourapple.cpp: In function 'BLEAdvertisementData getOAdvertisementData()':
C:\Users\...\nRFBox_V2\sourapple.cpp:84:55: error: no matching function for call to 'BLEAdvertisementData::addData(String)'
   advertisementData.addData(String((char *)packet, 17));
                                                       ^
In file included from C:\Users\...\Arduino15\packages\esp32\hardware\esp32\2.0.11\libraries\BLE\src/BLEServer.h:19,
                 from C:\Users\...\Arduino15\packages\esp32\hardware\esp32\2.0.11\libraries\BLE\src/BLEDevice.h:18,
                 from C:\Users\...\nRFBox_V2\sourapple.h:9,
                 from C:\Users\...\nRFBox_V2\sourapple.cpp:7:
C:\Users\....\packages\esp32\hardware\esp32\2.0.11\libraries\BLE\src/BLEAdvertising.h:33:7: note: candidate: 'void BLEAdvertisementData::addData(std::__cxx11::string)'
  void addData(std::string data);         // Add data to the payload.
       ^~~~~~~
C:\Users\...\packages\esp32\hardware\esp32\2.0.11\libraries\BLE\src/BLEAdvertising.h:33:7: note:   no known conversion for argument 1 from 'String' to 'std::__cxx11::string' {aka 'std::__cxx11::basic_string<char>'}
C:\Users\...\nRFBox_V2\blescan.cpp: In function 'void blescanLoop()':
C:\Users\...\nRFBox_V2\blescan.cpp:71:15: error: no match for 'operator*' (operand type is 'BLEScanResults')
     results = *scan->getResults();
               ^~~~~~~~~~~~~~~~~~~
C:\Users\...\nRFBox_V2\spoofer.cpp: In function 'BLEAdvertisementData getAdvertismentData()':
C:\Users\...\nRFBox_V2\spoofer.cpp:88:72: error: no matching function for call to 'BLEAdvertisementData::addData(String)'
     oAdvertisementData.addData(String((char*)DEVICES[device_index], 31));
                                                                        ^
In file included from C:\Users\...\packages\esp32\hardware\esp32\2.0.11\libraries\BLE\src/BLEServer.h:19,
                 from C:\Users\...\packages\esp32\hardware\esp32\2.0.11\libraries\BLE\src/BLEDevice.h:18,
                 from C:\Users\...\nRFBox-main\nRFBox_V2\spoofer.h:9,
                 from C:\Users\...\nRFBox-main\nRFBox_V2\spoofer.cpp:7:
C:\Users\...\packages\esp32\hardware\esp32\2.0.11\libraries\BLE\src/BLEAdvertising.h:33:7: note: candidate: 'void BLEAdvertisementData::addData(std::__cxx11::string)'
  void addData(std::string data);         // Add data to the payload.
       ^~~~~~~
C:\Users\...\packages\esp32\hardware\esp32\2.0.11\libraries\BLE\src/BLEAdvertising.h:33:7: note:   no known conversion for argument 1 from 'String' to 'std::__cxx11::string' {aka 'std::__cxx11::basic_string<char>'}

exit status 1

Compilation error: no matching function for call to 'BLEAdvertisementData::addData(String)'

from flash_download_tool_3.9.7 this:

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

any suggestion ?

many thanks,

L.

St0rmy88, 2025-04-06:
SOLVED !!!!!

use this ESP32 FLASHER !

https://github.com/esphome/esphome-flasher/releases/tag/1.4.0

Closed 2025-04-06.

Thread 53 (2025-04-02):

bin 2.5.0 not working. Blank screen, no output

Believeinus, 2025-04-02:
bin 2.5.0 showing black screen on esp32 30 pin. 2.2.1 works but 2.5.0 is black screen, no output

Nicoldik, 2025-04-11:
hi, I have this problem too, I suspect it's either esp32 or oled screen.

Nicoldik, 2025-04-13:
hello, I understand what the problem is. the problem is that esp32 is limited in 4MB versions (let's not mention versions with 8mb and 16mb of memory) of files up to 1.31 and the firmware weighs 1.54MB. you need (the firmware author) to make bootloader.bin and partitions.bin for the firmware

kosmostrater, 2025-04-28:
Same issue, 2.2.1 flashed ok and displays on the oled, but 2.5.0 does not display.

Nicoldik, 2025-05-20:
[kosmostrater](https://github.com/kosmostrater) the line "E (505) esp_image: Image length 1553536 doesn't fit in partition length 1310720
E (505) boot: OTA app partition slot 0 is not bootable
E (505) esp_image: image at 0x150000 has invalid magic byte (nothing flashed here?)
E (513) boot: OTA app partition slot 1 is not bootable
E (518) boot: No bootable app partitions in the partition table" says that the file .bin is heavy, so try using the .ino file.

Thread 54 (2025-04-13):

error found in nRF-BOX V2.5.0!

Nicoldik, 2025-04-13:
hello, I understand what the problem is. the problem is that esp32 is limited in 4mb versions (let's not mention versions with 8mb and 16MB of memory) of files up to 1.31 and the firmware weighs 1.54MB. you need to make bootloader.bin and partitions.bin for firmware

Thread 56 (2025-04-20):

Case Design anyone?

SunboX, 2025-04-20:
Hi,

did anyone already design a nice case for it?

greetings and thanks,
SunboX

zRCrackiiN, 2025-04-22:
i've done one, but im waiting until defcon to release it

SunboX, 2025-04-22:
Oh wow, that sounds great! 👍🏻 So I will wait.

Thread 58 (2025-04-21):

New version compilation error

mayjack0312, 2025-04-21:
Version used: `2.5.0`

The actual error is as follows
```
nRFBox-2.5.0\nRFBox_V2\spoofer.cpp: In function 'void setAdvertisingData()':
nRFBox-2.5.0\nRFBox_V2\spoofer.cpp:195:5: error: 'oAdvertisementData' was not declared in this scope; did you mean 'BLEAdvertisementData'?
  195 |     oAdvertisementData.addData(String((char *)packet, 17));
      |     ^~~~~~~~~~~~~~~~~~
      |     BLEAdvertisementData
nRFBox-2.5.0\nRFBox_V2\spoofer.cpp:195:47: error: 'packet' was not declared in this scope
  195 |     oAdvertisementData.addData(String((char *)packet, 17));
      |                                               ^~~~~~
```

The code is modified as follows (compiled, but the function has not been tested yet)

```
/* ____________________________
   This software is licensed under the MIT License:
   https://github.com/cifertech/nrfbox
   ________________________________________ */

#include <Arduino.h>
#include "spoofer.h"

extern U8G2_SSD1306_128X64_NONAME_F_HW_I2C u8g2;

BLEAdvertising *pAdvertising;
BLEAdvertisementData oAdvertisementData; // Moved to global scope

const int deviceTypeNextPin = 26;
const int deviceTypePrevPin = 33;
const int advTypeNextPin = 25;
const int advControlPin = 27;

unsigned long lastDebounceTimeNext = 0;
unsigned long lastDebounceTimePrev = 0;
unsigned long lastDebounceTimeAdvNext = 0;
unsigned long lastDebounceTimeAdvPrev = 0;

int lastButtonStateNext = LOW;
int lastButtonStatePrev = LOW;
int lastButtonStateAdvNext = LOW;
int lastButtonStateAdvPrev = LOW;

unsigned long lastDebounceTime = 0;
unsigned long debounceDelay = 500;

bool isAdvertising = true;

int deviceType = 1;
int delaySeconds = 1;
int advType = 1;

// Payload data
uint8_t dataAirpods[31] = {0x1e, 0xff, 0x4c, 0x00, 0x07, 0x19, 0x07, 0x02, 0x20, 0x75, 0xaa, 0x30, 0x01, 0x00, 0x00, 0x45, 0x12, 0x12, 0x12, 0x00, 0x00, 0x00, 0x00, 0x00, 0x00, 0x00, 0x00, 0x00, 0x00, 0x00, 0x00};
uint8_t dataAirpodsPro[31] = {0x1e, 0xff, 0x4c, 0x00, 0x07, 0x19, 0x07, 0x0e, 0x20, 0x75, 0xaa, 0x30, 0x01, 0x00, 0x00, 0x45, 0x12, 0x12, 0x12, 0x00, 0x00, 0x00, 0x00, 0x00, 0x00, 0x00, 0x00, 0x00, 0x00, 0x00, 0x00};
uint8_t dataAirpodsMax[31] = {0x1e, 0xff, 0x4c, 0x00, 0x07, 0x19, 0x07, 0x0a, 0x20, 0x75, 0xaa, 0x30, 0x01, 0x00, 0x00, 0x45, 0x12, 0x12, 0x12, 0x00, 0x00, 0x00, 0x00, 0x00, 0x00, 0x00, 0x00, 0x00, 0x00, 0x00, 0x00};
uint8_t dataAirpodsGen2[31] = {0x1e, 0xff, 0x4c, 0x00, 0x07, 0x19, 0x07, 0x0f, 0x20, 0x75, 0xaa, 0x30, 0x01, 0x00, 0x00, 0x45, 0x12, 0x12, 0x12, 0x00, 0x00, 0x00, 0x00, 0x00, 0x00, 0x00, 0x00, 0x00, 0x00, 0x00, 0x00};
uint8_t dataAirpodsGen3[31] = {0x1e, 0xff, 0x4c, 0x00, 0x07, 0x19, 0x07, 0x13, 0x20, 0x75, 0xaa, 0x30, 0x01, 0x00, 0x00, 0x45, 0x12, 0x12, 0x12, 0x00, 0x00, 0x00, 0x00, 0x00, 0x00, 0x00, 0x00, 0x00, 0x00, 0x00, 0x00};
uint8_t dataAirpodsProGen2[31] = {0x1e, 0xff, 0x4c, 0x00, 0x07, 0x19, 0x07, 0x14, 0x20, 0x75, 0xaa, 0x30, 0x01, 0x00, 0x00, 0x45, 0x12, 0x12, 0x12, 0x00, 0x00, 0x00, 0x00, 0x00, 0x00, 0x00, 0x00, 0x00, 0x00, 0x00, 0x00};
uint8_t dataPowerBeats[31] = {0x1e, 0xff, 0x4c, 0x00, 0x07, 0x19, 0x07, 0x03, 0x20, 0x75, 0xaa, 0x30, 0x01, 0x00, 0x00, 0x45, 0x12, 0x12, 0x12, 0x00, 0x00, 0x00, 0x00, 0x00, 0x00, 0x00, 0x00, 0x00, 0x00, 0x00, 0x00};
uint8_t dataPowerBeatsPro[31] = {0x1e, 0xff, 0x4c, 0x00, 0x07, 0x19, 0x07, 0x0b, 0x20, 0x75, 0xaa, 0x30, 0x01, 0x00, 0x00, 0x45, 0x12, 0x12, 0x12, 0x00, 0x00, 0x00, 0x00, 0x00, 0x00, 0x00, 0x00, 0x00, 0x00, 0x00, 0x00};
uint8_t dataBeatsSoloPro[31] = {0x1e, 0xff, 0x4c, 0x00, 0x07, 0x19, 0x07, 0x0c, 0x20, 0x75, 0xaa, 0x30, 0x01, 0x00, 0x00, 0x45, 0x12, 0x12, 0x12, 0x00, 0x00, 0x00, 0x00, 0x00, 0x00, 0x00, 0x00, 0x00, 0x00, 0x00, 0x00};
uint8_t dataBeatsStudioBuds[31] = {0x1e, 0xff, 0x4c, 0x00, 0x07, 0x19, 0x07, 0x11, 0x20, 0x75, 0xaa, 0x30, 0x01, 0x00, 0x00, 0x45, 0x12, 0x12, 0x12, 0x00, 0x00, 0x00, 0x00, 0x00, 0x00, 0x00, 0x00, 0x00, 0x00, 0x00, 0x00};
uint8_t dataBeatsFlex[31] = {0x1e, 0xff, 0x4c, 0x00, 0x07, 0x19, 0x07, 0x10, 0x20, 0x75, 0xaa, 0x30, 0x01, 0x00, 0x00, 0x45, 0x12, 0x12, 0x12, 0x00, 0x00, 0x00, 0x00, 0x00, 0x00, 0x00, 0x00, 0x00, 0x00, 0x00, 0x00};
uint8_t dataBeatsX[31] = {0x1e, 0xff, 0x4c, 0x00, 0x07, 0x19, 0x07, 0x05, 0x20, 0x75, 0xaa, 0x30, 0x01, 0x00, 0x00, 0x45, 0x12, 0x12, 0x12, 0x00, 0x00, 0x00, 0x00, 0x00, 0x00, 0x00, 0x00, 0x00, 0x00, 0x00, 0x00};
uint8_t dataBeatsSolo3[31] = {0x1e, 0xff, 0x4c, 0x00, 0x07, 0x19, 0x07, 0x06, 0x20, 0x75, 0xaa, 0x30, 0x01, 0x00, 0x00, 0x45, 0x12, 0x12, 0x12, 0x00, 0x00, 0x00, 0x00, 0x00, 0x00, 0x00, 0x00, 0x00, 0x00, 0x00, 0x00};
uint8_t dataBeatsStudio3[31] = {0x1e, 0xff, 0x4c, 0x00, 0x07, 0x19, 0x07, 0x09, 0x20, 0x75, 0xaa, 0x30, 0x01, 0x00, 0x00, 0x45, 0x12, 0x12, 0x12, 0x00, 0x00, 0x00, 0x00, 0x00, 0x00, 0x00, 0x00, 0x00, 0x00, 0x00, 0x00};
uint8_t dataBeatsStudioPro[31] = {0x1e, 0xff, 0x4c, 0x00, 0x07, 0x19, 0x07, 0x17, 0x20, 0x75, 0xaa, 0x30, 0x01, 0x00, 0x00, 0x45, 0x12, 0x12, 0x12, 0x00, 0x00, 0x00, 0x00, 0x00, 0x00, 0x00, 0x00, 0x00, 0x00, 0x00, 0x00};
uint8_t dataBeatsFitPro[31] = {0x1e, 0xff, 0x4c, 0x00, 0x07, 0x19, 0x07, 0x12, 0x20, 0x75, 0xaa, 0x30, 0x01, 0x00, 0x00, 0x45, 0x12, 0x12, 0x12, 0x00, 0x00, 0x00, 0x00, 0x00, 0x00, 0x00, 0x00, 0x00, 0x00, 0x00, 0x00};
uint8_t dataBeatsStudioBudsPlus[31] = {0x1e, 0xff, 0x4c, 0x00, 0x07, 0x19, 0x07, 0x16, 0x20, 0x75, 0xaa, 0x30, 0x01, 0x00, 0x00, 0x45, 0x12, 0x12, 0x12, 0x00, 0x00, 0x00, 0x00, 0x00, 0x00, 0x00, 0x00, 0x00, 0x00, 0x00, 0x00};
uint8_t dataAppleTVSetup[23] = {0x16, 0xff, 0x4c, 0x00, 0x04, 0x04, 0x2a, 0x00, 0x00, 0x00, 0x0f, 0x05, 0xc1, 0x01, 0x60, 0x4c, 0x95, 0x00, 0x00, 0x10, 0x00, 0x00, 0x00};
uint8_t dataAppleTVPair[23] = {0x16, 0xff, 0x4c, 0x00, 0x04, 0x04, 0x2a, 0x00, 0x00, 0x00, 0x0f, 0x05, 0xc1, 0x06, 0x60, 0x4c, 0x95, 0x00, 0x00, 0x10, 0x00, 0x00, 0x00};
uint8_t dataAppleTVNewUser[23] = {0x16, 0xff, 0x4c, 0x00, 0x04, 0x04, 0x2a, 0x00, 0x00, 0x00, 0x0f, 0x05, 0xc1, 0x20, 0x60, 0x4c, 0x95, 0x00, 0x00, 0x10, 0x00, 0x00, 0x00};
uint8_t dataAppleTVAppleIDSetup[23] = {0x16, 0xff, 0x4c, 0x00, 0x04, 0x04, 0x2a, 0x00, 0x00, 0x00, 0x0f, 0x05, 0xc1, 0x2b, 0x60, 0x4c, 0x95, 0x00, 0x00, 0x10, 0x00, 0x00, 0x00};
uint8_t dataAppleTVWirelessAudioSync[23] = {0x16, 0xff, 0x4c, 0x00, 0x04, 0x04, 0x2a, 0x00, 0x00, 0x00, 0x0f, 0x05, 0xc1, 0xc0, 0x60, 0x4c, 0x95, 0x00, 0x00, 0x10, 0x00, 0x00, 0x00};
uint8_t dataAppleTVHomekitSetup[23] = {0x16, 0xff, 0x4c, 0x00, 0x04, 0x04, 0x2a, 0x00, 0x00, 0x00, 0x0f, 0x05, 0xc1, 0x0d, 0x60, 0x4c, 0x95, 0x00, 0x00, 0x10, 0x00, 0x00, 0x00};
uint8_t dataAppleTVKeyboard[23] = {0x16, 0xff, 0x4c, 0x00, 0x04, 0x04, 0x2a, 0x00, 0x00, 0x00, 0x0f, 0x05, 0xc1, 0x13, 0x60, 0x4c, 0x95, 0x00, 0x00, 0x10, 0x00, 0x00, 0x00};
uint8_t dataAppleTVConnectingToNetwork[23] = {0x16, 0xff, 0x4c, 0x00, 0x04, 0x04, 0x2a, 0x00, 0x00, 0x00, 0x0f, 0x05, 0xc1, 0x27, 0x60, 0x4c, 0x95, 0x00, 0x00, 0x10, 0x00, 0x00, 0x00};
uint8_t dataHomepodSetup[23] = {0x16, 0xff, 0x4c, 0x00, 0x04, 0x04, 0x2a, 0x00, 0x00, 0x00, 0x0f, 0x05, 0xc1, 0x0b, 0x60, 0x4c, 0x95, 0x00, 0x00, 0x10, 0x00, 0x00, 0x00};
uint8_t dataSetupNewPhone[23] = {0x16, 0xff, 0x4c, 0x00, 0x04, 0x04, 0x2a, 0x00, 0x00, 0x00, 0x0f, 0x05, 0xc1, 0x09, 0x60, 0x4c, 0x95, 0x00, 0x00, 0x10, 0x00, 0x00, 0x00};
uint8_t dataTransferNumber[23] = {0x16, 0xff, 0x4c, 0x00, 0x04, 0x04, 0x2a, 0x00, 0x00, 0x00, 0x0f, 0x05, 0xc1, 0x02, 0x60, 0x4c, 0x95, 0x00, 0x00, 0x10, 0x00, 0x00, 0x00};
uint8_t dataTVColorBalance[23] = {0x16, 0xff, 0x4c, 0x00, 0x04, 0x04, 0x2a, 0x00, 0x00, 0x00, 0x0f, 0x05, 0xc1, 0x1e, 0x60, 0x4c, 0x95, 0x00, 0x00, 0x10, 0x00, 0x00, 0x00};

void updateDisplay() {
  u8g2.clearBuffer();

  // Display device type
  u8g2.setFont(u8g2_font_profont11_tf);
  u8g2.drawStr(0, 10, "Device:");
  int x = 0;
  int y = 25;

  switch (deviceType) {
    case 1:
      u8g2.drawStr(x, y, "[ Airpods ]");
      break;
    case 2:
      u8g2.drawStr(x, y, "[ Airpods Pro ]");
      break;
    case 3:
      u8g2.drawStr(x, y, "[ Airpods Max ]");
      break;
    case 4:
      u8g2.drawStr(x, y, "[ Airpods Gen 2 ]");
      break;
    case 5:
      u8g2.drawStr(x, y, "[ Airpods Gen 3 ]");
      break;
    case 6:
      u8g2.drawStr(x, y, "[ Airpods Gen 2 ]");
      break;
    case 7:
      u8g2.drawStr(x, y, "[ PowerBeats ]");
      break;
    case 8:
      u8g2.drawStr(x, y, "[ PowerBeats Pro ]");
      break;
    case 9:
      u8g2.drawStr(x, y, "[ Beats Solo Pro ]");
      break;
    case 10:
      u8g2.drawStr(x, y, "[ Beats Buds ]");
      break;
    case 11:
      u8g2.drawStr(x, y, "[ Beats Flex ]");
      break;
    case 12:
      u8g2.drawStr(x, y, "[ BeatsX ]");
      break;
    case 13:
      u8g2.drawStr(x, y, "[ Beats Solo3 ]");
      break;
    case 14:
      u8g2.drawStr(x, y, "[ Beats Studio3 ]");
      break;
    case 15:
      u8g2.drawStr(x, y, "[ Beats StudioPro ]");
      break;
    case 16:
      u8g2.drawStr(x, y, "[ Beats FitPro ]");
      break;
    case 17:
      u8g2.drawStr(x, y, "[ Beats BudsPlus ]");
      break;
    case 18:
      u8g2.drawStr(x, y, "[ AppleTV Setup ]");
      break;
    case 19:
      u8g2.drawStr(x, y, "[ AppleTV Pair ]");
      break;
    case 20:
      u8g2.drawStr(x, y, "[ AppleTV NewUser ]");
      break;
    case 21:
      u8g2.drawStr(x, y, "[ AppleTV ID ]");
      break;
    case 22:
      u8g2.drawStr(x, y, "[ AppleTV Audio ]");
      break;
    case 23:
      u8g2.drawStr(x, y, "[ AppleTV Homekit ]");
      break;
    case 24:
      u8g2.drawStr(x, y, "[ AppleTV Keyboard ]");
      break;
    case 25:
      u8g2.drawStr(x, y, "[ AppleTV Network ]");
      break;
    case 26:
      u8g2.drawStr(x, y, "[ TVColorBalance ]");
      break;
    default:
      u8g2.drawStr(x, y, "[ Airpods ]");
      break;
  }

  u8g2.drawStr(0, 45, "Adv Type:");

  switch (advType) {
    case 1:
      u8g2.drawStr(60, 45, "IND");
      break;
    case 2:
      u8g2.drawStr(60, 45, "DIRECT HIGH");
      break;
    case 3:
      u8g2.drawStr(60, 45, "SCAN");
      break;
    case 4:
      u8g2.drawStr(60, 45, "NONCONN");
      break;
    case 5:
      u8g2.drawStr(60, 45, "DIRECT LOW");
      break;
  }

  u8g2.drawStr(0, 64, "Advertising:");
  u8g2.setCursor(80, 64);
  u8g2.print(isAdvertising ? "Disable" : "Active");

  u8g2.sendBuffer();
}

void setAdvertisingData() {
  // Note: The following line is commented out because 'packet' is undefined.
  // If 'packet' is meant to be a specific uint8_t array (e.g., dataAirpods),
  // define it or replace 'packet' with the correct array.
  // Example: oAdvertisementData.addData(String((char *)dataAirpods, 17));
  // oAdvertisementData.addData(String((char *)packet, 17));

  switch (deviceType) {
    case 1:
      oAdvertisementData.setManufacturerData(String((char *)dataAirpods, 31));
      break;
    case 2:
      oAdvertisementData.setManufacturerData(String((char *)dataAirpodsPro, 31));
      break;
    case 3:
      oAdvertisementData.setManufacturerData(String((char *)dataAirpodsMax, 31));
      break;
    case 4:
      oAdvertisementData.setManufacturerData(String((char *)dataAirpodsGen2, 31));
      break;
    case 5:
      oAdvertisementData.setManufacturerData(String((char *)dataAirpodsGen3, 31));
      break;
    case 6:
      oAdvertisementData.setManufacturerData(String((char *)dataAirpodsProGen2, 31));
      break;
    case 7:
      oAdvertisementData.setManufacturerData(String((char *)dataPowerBeats, 31));
      break;
    case 8:
      oAdvertisementData.setManufacturerData(String((char *)dataPowerBeatsPro, 31));
      break;
    case 9:
      oAdvertisementData.setManufacturerData(String((char *)dataBeatsSoloPro, 31));
      break;
    case 10:
      oAdvertisementData.setManufacturerData(String((char *)dataBeatsStudioBuds, 31));
      break;
    case 11:
      oAdvertisementData.setManufacturerData(String((char *)dataBeatsFlex, 31));
      break;
    case 12:
      oAdvertisementData.setManufacturerData(String((char *)dataBeatsX, 31));
      break;
    case 13:
      oAdvertisementData.setManufacturerData(String((char *)dataBeatsSolo3, 31));
      break;
    case 14:
      oAdvertisementData.setManufacturerData(String((char *)dataBeatsStudio3, 31));
      break;
    case 15:
      oAdvertisementData.setManufacturerData(String((char *)dataBeatsStudioPro, 31));
      break;
    case 16:
      oAdvertisementData.setManufacturerData(String((char *)dataBeatsFitPro, 31));
      break;
    case 17:
      oAdvertisementData.setManufacturerData(String((char *)dataBeatsStudioBudsPlus, 31));
      break;
    case 18:
      oAdvertisementData.setManufacturerData(String((char *)dataAppleTVSetup, 23)); // Adjusted length to 23
      break;
    case 19:
      oAdvertisementData.setManufacturerData(String((char *)dataAppleTVPair, 23));
      break;
    case 20:
      oAdvertisementData.setManufacturerData(String((char *)dataAppleTVNewUser, 23));
      break;
    case 21:
      oAdvertisementData.setManufacturerData(String((char *)dataAppleTVAppleIDSetup, 23));
      break;
    case 22:
      oAdvertisementData.setManufacturerData(String((char *)dataAppleTVWirelessAudioSync, 23));
      break;
    case 23:
      oAdvertisementData.setManufacturerData(String((char *)dataAppleTVHomekitSetup, 23));
      break;
    case 24:
      oAdvertisementData.setManufacturerData(String((char *)dataAppleTVKeyboard, 23));
      break;
    case 25:
      oAdvertisementData.setManufacturerData(String((char *)dataAppleTVConnectingToNetwork, 23));
      break;
    case 26:
      oAdvertisementData.setManufacturerData(String((char *)dataTVColorBalance, 23));
      break;
    default:
      oAdvertisementData.setManufacturerData(String((char *)dataAirpods, 31));
      break;
  }

  pAdvertising->setAdvertisementData(oAdvertisementData);
  Serial.println("Advertising data set.");
  updateDisplay();
}

void handleButtonPress(int pin, void (*callback)()) {
  int reading = digitalRead(pin);

  if (reading == LOW) {
    unsigned long currentTime = millis();
    delay(300);
    updateDisplay();

    if ((currentTime - lastDebounceTime) > debounceDelay) {
      callback();
      lastDebounceTime = currentTime;
    }
  }
}

void changeDeviceTypeNext() {
  deviceType++;
  if (deviceType > 26) deviceType = 1;
  Serial.println("Device Type Next: " + String(deviceType));
  setAdvertisingData();
  updateDisplay();
}

void changeDeviceTypePrev() {
  deviceType--;
  if (deviceType < 1) deviceType = 26;
  Serial.println("Device Type Prev: " + String(deviceType));
  setAdvertisingData();
  updateDisplay();
}

void changeAdvTypeNext() {
  advType++;
  if (advType > 5) advType = 1;
  Serial.println("Advertising Type Next: " + String(advType));
  setAdvertisingData();
  updateDisplay();
}

void changeAdvTypePrev() {
  advType--;
  if (advType < 1) advType = 5;
  Serial.println("Advertising Type Prev: " + String(advType));
  setAdvertisingData();
  updateDisplay();
}

void toggleAdvertising() {
  if (isAdvertising) {
    pAdvertising->stop();
    Serial.println("Advertising stopped.");
    updateDisplay();
  } else {
    pAdvertising->start();
    Serial.println("Advertising started.");
    updateDisplay();
  }
  isAdvertising = !isAdvertising;
}

void spooferSetup() {
  Serial.begin(115200);
  Serial.println("Starting ESP32 BLE");

  esp_ble_tx_power_set(ESP_BLE_PWR_TYPE_DEFAULT, ESP_PWR_LVL_P9);
  esp_ble_tx_power_set(ESP_BLE_PWR_TYPE_ADV, ESP_PWR_LVL_P9);
  esp_ble_tx_power_set(ESP_BLE_PWR_TYPE_SCAN, ESP_PWR_LVL_P9);

  u8g2.begin();
  updateDisplay();

  BLEDevice::init("");

  BLEServer *pServer = BLEDevice::createServer();

  pAdvertising = pServer->getAdvertising();
  // oAdvertisementData is now global, no need to declare here
  // BLEAdvertisementData oAdvertisementData = BLEAdvertisementData();

  pinMode(deviceTypeNextPin, INPUT_PULLUP);
  pinMode(deviceTypePrevPin, INPUT_PULLUP);
  pinMode(advTypeNextPin, INPUT_PULLUP);
  pinMode(advControlPin, INPUT_PULLUP);
}

void spooferLoop() {
  handleButtonPress(deviceTypeNextPin, changeDeviceTypeNext);
  handleButtonPress(deviceTypePrevPin, changeDeviceTypePrev);
  handleButtonPress(advTypeNextPin, changeAdvTypeNext);
  handleButtonPress(advControlPin, toggleAdvertising);
}
```

Thread 63 (2025-04-28):

BLE compile error

kosmostrater, 2025-04-28:
When Trying to compile I get this error. Tried to compile several PC's
using Arduino 1.8.19 ISE
Tried ESP32 Dev,  ESP32 Wroom, ESP32-S3. Always get the same error

C:\Users\user\Documents\Arduino\nRFBox\nRFBox_V2\blescan.cpp: In function 'void blescanLoop()':
blescan.cpp:71:32: error: no match for 'operator=' (operand types are 'BLEScanResults' and 'BLEScanResults*')
   71 |     results = scan->getResults();
      |                                ^
In file included from C:\Users\user\AppData\Local\Arduino15\packages\esp32\hardware\esp32\3.0.7\libraries\BLE\src/BLEAdvertisedDevice.h:20,
                 from C:\Users\user\AppData\Local\Arduino15\packages\esp32\hardware\esp32\3.0.7\libraries\BLE\src/BLEClient.h:25,
                 from C:\Users\user\AppData\Local\Arduino15\packages\esp32\hardware\esp32\3.0.7\libraries\BLE\src/BLEDevice.h:22,
                 from C:\Users\user\Documents\Arduino\nRFBox\nRFBox_V2\blescan.h:9,
                 from C:\Users\user\Documents\Arduino\nRFBox\nRFBox_V2\blescan.cpp:7:
C:\Users\user\AppData\Local\Arduino15\packages\esp32\hardware\esp32\3.0.7\libraries\BLE\src/BLEScan.h:48:7: note: candidate: 'BLEScanResults& BLEScanResults::operator=(const BLEScanResults&)'
   48 | class BLEScanResults {
      |       ^~~~~~~~~~~~~~
C:\Users\user\AppData\Local\Arduino15\packages\esp32\hardware\esp32\3.0.7\libraries\BLE\src/BLEScan.h:48:7: note:   no known conversion for argument 1 from 'BLEScanResults*' to 'const BLEScanResults&'
C:\Users\user\AppData\Local\Arduino15\packages\esp32\hardware\esp32\3.0.7\libraries\BLE\src/BLEScan.h:48:7: note: candidate: 'BLEScanResults& BLEScanResults::operator=(BLEScanResults&&)'
C:\Users\user\AppData\Local\Arduino15\packages\esp32\hardware\esp32\3.0.7\libraries\BLE\src/BLEScan.h:48:7: note:   no known conversion for argument 1 from 'BLEScanResults*' to 'BLEScanResults&&'
exit status 1
no match for 'operator=' (operand types are 'BLEScanResults' and 'BLEScanResults*')

Thread 64 (2025-05-09):

OLED display doesn’t work (ESP32 C6)

Andrew32151, 2025-05-09:
Hello

I tried for the first time to do this kind of circuits like Nrf box v2 and Uploaded the filmware on ESP32 C6 and after restarting it the Oled screen i connected to it doesnt shows up something

Can somone help to solve this problem ??

RoToSpLaSh, 2025-05-10:
Do you try change pin SDL and SCA?

Andrew32151, 2025-05-10:
> Do you try change pin SDL and SCA?

No i have SDL=21 SCA=22 so were to try to put them now ?

(Also im not sure but i think after a little research that it will work only on 0.96 oled screen because it's SSD1306 and my oled 1.3 that has SH1106)

RoToSpLaSh, 2025-05-10:
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

Yes ,only on 0.96 oled, with ssd1306, I didn't pay attention to the screen model you had specifically, sorry!!

Andrew32151, 2025-05-10:
Ohh ok nevermind, so now I'm trying to install bluejammer and now it sent me an error and tell me to reset the ESP32 or PRESS BOOT but nothing works so I guess I go to blue jammer forum for this.

also thank you so much for your time to help me out!!

Thread 66 (2025-06-17):

Charging Battery released Magic Smoke

SunboX, 2025-06-17:
I did build a nRFBOX V2 which is working fine so far.

But when I did try to charge a battery, it worked fine at first but after some minutes it released the "Magic Smoked". Can someone tell what I did wrong?

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

stonedDiscord, 2025-06-18:
The capacitors C8 and C9 are installed in reverse.

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

stonedDiscord, 2025-06-18:
The markings on the PCB indicate the negative side, the line on the capacitor itself marks the positive side.

gel3k, 2025-06-25:
hey, where did you get this 'battery holder' pcb ?

SunboX, 2025-06-25:
@gel3k I made it myself. ;) With KiCAD it's very easy.

Thread 68 (2025-06-23):

Flash issue

atlab95, 2025-06-23:
After flashing the bin and the partitions files as per wiki instruction, i got no display. Checking via serial monitor i get:

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

also, getting flash info from esptool:

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
Edit
Tried with Arduino IDE as well but the sketch size exceed the flash size:

> Sketch uses 1614665 bytes (123%) of program storage space. Maximum is 1310720 bytes.

So isn't the 4MB version enough?

RoToSpLaSh, 2025-06-24:
https://youtube.com/shorts/mLxOKxSP5hE?si=1CS55c8Xdx2kmFBi

Closed 2025-06-24.

Thread 78 (2025-08-25):

File error cannot view pcb size

Trhug25, 2025-08-25:
I sent the pcb v2 design file to the printing factory but they said the file was corrupted and couldn't see the pcb size and the hole diameter was below 0.3 so it couldn't be drilled. Can I have the pcb dimensions and hole diameters for v2 again?

Closed 2025-08-27.

Thread 80 (2025-09-10):

Not working

01rihito01-png, 2025-09-10:
I charge the program but instead of workin red and blue light are always on and it doesnt do anything
Can someone help me
