cifertech/nRFBox/nRFBox/config.h

/* ____________________________
   This software is licensed under the MIT License:
   https://github.com/cifertech/nrfbox
   ________________________________________ */

#ifndef CONFIG_H
#define CONFIG_H

#define SCREEN_WIDTH 128
#define SCREEN_HEIGHT 64

// Push Buttons-specific Pins
#define BUTTON_UP_PIN       26 
#define BUTTON_SELECT_PIN   33
#define BUTTON_DOWN_PIN     32 
#define BTN_PIN_RIGHT       27
#define BTN_PIN_LEFT        25

// SD Card Slot-specific Pins
#define SD_CS_PIN 5
#define FIRMWARE_FILE "/firmware.bin"

// nRF24-specific Pins
#define NRF_CE_PIN_A    5   
#define NRF_CSN_PIN_A   17 
#define NRF_CE_PIN_B    16  
#define NRF_CSN_PIN_B   4  
#define NRF_CE_PIN_C    15  
#define NRF_CSN_PIN_C   2  

// Common dependencies
#include "setting.h"
#include <Arduino.h>
#include <U8g2lib.h>
#include <Wire.h>
#include <SPI.h>
#include <Adafruit_NeoPixel.h>
#include <EEPROM.h>
#include <Preferences.h>
#include <vector>
#include <string>
#include <SD.h>
#include <Update.h>

U8G2_SSD1306_128X64_NONAME_F_HW_I2C u8g2(U8G2_R0, /* reset=*/ U8X8_PIN_NONE);

Adafruit_NeoPixel pixels(1, 14, NEO_GRB + NEO_KHZ800);

// BLE-specific dependencies
#include <BLEDevice.h>
#include <BLEUtils.h>
#include <BLEServer.h>

// nRF24-specific dependencies
#include <nRF24L01.h>
#include <RF24.h>

// WiFi-specific dependencies
#include <WiFi.h>
#include <esp_wifi.h>
#include <esp_wifi_types.h>
#include <esp_system.h>
#include <esp_event.h>
#include <nvs_flash.h>
#include <string>

// ESP-specific configurations
#include <esp_bt.h>
#include <esp_wifi.h>

// External declarations
extern U8G2_SSD1306_128X64_NONAME_F_HW_I2C u8g2;
extern Adafruit_NeoPixel pixels;

// BLE-related namespaces
namespace BleJammer {
  void blejammerSetup();
  void blejammerLoop();
}

namespace BleScan {
  void blescanSetup();
  void blescanLoop();
}

namespace SourApple {
  void sourappleSetup();
  void sourappleLoop();
}

namespace Spoofer {
  void spooferSetup();
  void spooferLoop();
}

// nRF24-related namespaces
namespace Analyzer {
  void analyzerSetup();
  void analyzerLoop();
}

namespace ProtoKill {
  void blackoutSetup();
  void blackoutLoop();
}

namespace Scanner {
  void scannerSetup();
  void scannerLoop();
}

namespace Jammer {
  void jammerSetup();
  void jammerLoop();
}

// WiFi-related namespaces
namespace WifiScan {
  void wifiscanSetup();
  void wifiscanLoop();
}

namespace Deauther {
  void deautherSetup();
  void deautherLoop();
}

#endif // CONFIG_H
