cifertech/nRFBox/(notices)

Notices in the files:
README.md:
License: MIT
